adafruit/Adafruit-TSC2046-PCB/Adafruit TSC2046 Breakout.brd

## EAGLE design Adafruit TSC2046 Breakout.brd (2023-07-26)

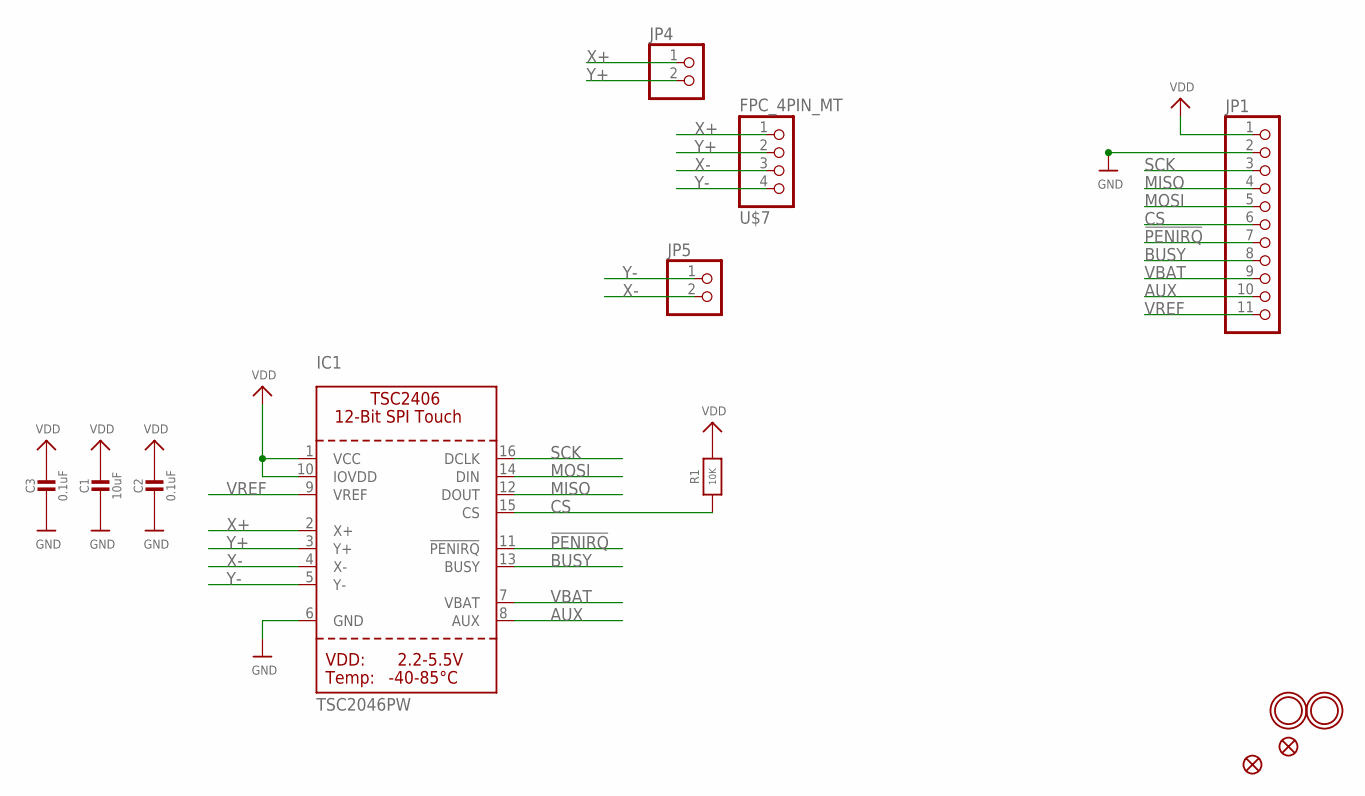
[picture p2: schematic Adafruit TSC2046 Breakout.sch]

Parts:
C1: 10uF; 0805-NO
C2, C3: 0.1uF; 0603-NO
FID2, FID3: FIDUCIAL_1MM
IC1: TSC2046PW; TSSOP16
JP1: HEADER-1X11; 1X11_ROUND
JP4, JP5: HEADER-1X2ROUND; 1X02_ROUND
R1: 10K; 0603-NO
U$4, U$5: MOUNTINGHOLE2.5; MOUNTINGHOLE_2.5_PLATED
U$7: FPC_4PIN_MT; FPC_CONN_1MM_DUAL_4P_MT

Connections:
!PENIRQ: IC1.11 (!PENIRQ), JP1.7
AUX: IC1.8 (AUX), JP1.10
BUSY: IC1.13 (BUSY), JP1.8
CS: IC1.15 (CS), JP1.6, R1.1
GND: C1.2, C2.2, C3.2, IC1.6 (GND), JP1.2
MISO: IC1.12 (DOUT), JP1.4
MOSI: IC1.14 (DIN), JP1.5
SCK: IC1.16 (DCLK), JP1.3
VBAT: IC1.7 (VBAT), JP1.9
VDD: C1.1, C2.1, C3.1, IC1.1 (VCC), IC1.10 (IOVDD), JP1.1, R1.2
VREF: IC1.9 (VREF), JP1.11
X+: IC1.2 (X+), JP4.1, U$7.1 (4)
X-: IC1.4 (X-), JP5.2, U$7.3 (2)
Y+: IC1.3 (Y+), JP4.2, U$7.2 (3)
Y-: IC1.5 (Y-), JP5.1, U$7.4 (1)

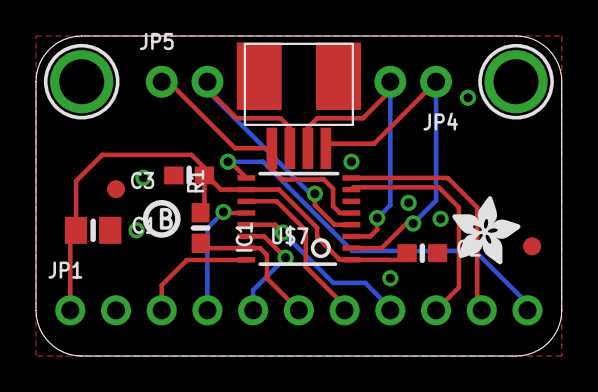
[picture p3: board Adafruit TSC2046 Breakout.brd from above]

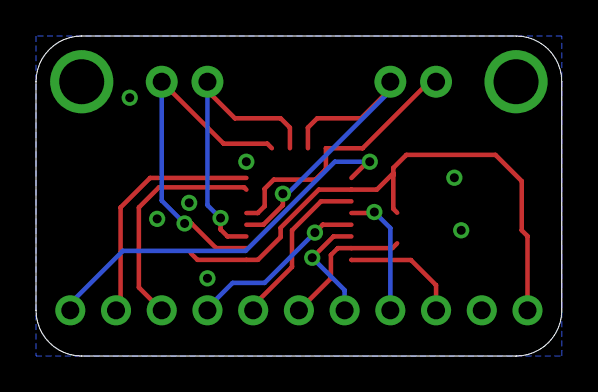
[picture p4: board Adafruit TSC2046 Breakout.brd from below]

Board: 2 copper layers, 29.2 x 17.8 mm, 34 parts (2 on the bottom side), 15 nets.

Other parts of the board:
PLABEL0: PLABEL0
PLABEL1: PLABEL1
PLABEL2: PLABEL2
PLABEL3: PLABEL3
PLABEL4: PLABEL4
PLABEL5: PLABEL5
PLABEL6: PLABEL6
PLABEL7: PLABEL7
PLABEL8: PLABEL8
PLABEL9: PLABEL9
PLABEL10: PLABEL10
PLABEL11: PLABEL11
PLABEL12: PLABEL12
PLABEL13: PLABEL13
PLABEL14: PLABEL14
PLABEL15: PLABEL15
PLABEL16: PLABEL16
PLABEL17: PLABEL17
PLABEL18: PLABEL18
U$6: PCBFEAT-REV-040
U$8: ADAFRUIT_3.5MM
